HMS-RIC/Two-Armed-Bandit-PCB/Two Armed Bandit BOM.xlsx

Two Armed Bandit PCB
Bill of Materials
Value | Description | Qty | Vendor | Part Number | Price | Total | Notes
U1 | ULN2803A (Darlington Array) | 1 | Digikey | 497-2356-5-ND | $1.19 | $1.19 | Can be exchanged with ULQ2803A
J23 | BNCPTH | 1 | Digikey | A97555-ND | $2.15 | $2.15 | Substitute with any comparable part
J5–7, 10,15, 17 | 2-pin header (MTA-100) | 6 |  | A19423-ND | $0.10 | $0.60 | Or any other suitable connector
J3, J4, J12 | 3-pin header (MTA-100) | 3 |  | A19430-ND | $0.14 | $0.42 | Or any other suitable connector
J1, J2, J11 | 5x screw term, 3.5mm | 3 |  | 277-5827-ND | $3.26 | $3.26 | Alternatively: WM7861-ND
J8, J9, J16, J19 | 6x screw term, 3.5mm | 4 |  | 277-5779-ND | $3.74 | $14.96 | Alternatively: WM7862-ND
J13 | 8-pin socket | 1 |  | S7041-ND | $0.67 | $0.67
J14 | PJ-202A Power Jack | 1 |  | CP-202A-ND | $0.60 | $0.60
R1, R2, R5 | axial resistor for LED | 3 |  |  |  | $0.00
R3, R4, R6 | 160 Ω axial resistor | 3 |  |  |  | $0.00
J30 | 10-pin header | 1 |  | S1012EC-40-ND | $0.51 | $0.51 | get 40-pin header and break to size
J31,32 | 8-pin header | 0 |  | S1012EC-40-ND |  | $0.00 | get 40-pin header and break to size
J33 | 6-pin header | 0 |  | S1012EC-40-ND |  | $0.00 | get 40-pin header and break to size
 | For Ribbon Cable Connectors:
 | 2-pin MTA-100 connector (for ribbon) |  |  | A31080-ND | $0.15
 | 3-pin MTA-100 connector (for ribbon) |  |  | A31081-ND | $0.19
 | MTA-100 Crimper (if needed) |  |  | 58579-1 | $400.00 |  | Can be found at Digikey, Newark, Amazon, or direct from TE connectivity
 | Arduino Uno | 1 |  |  |  | $0.00
 | 1" Standoffs 4-40 | 4 | McMaster | 92745A326 | $0.46 | $1.84
