HMS-RIC/Two-Armed-Bandit-PCB/Gerber/v1.1/TwoArmedBandit_v1.1.dxf

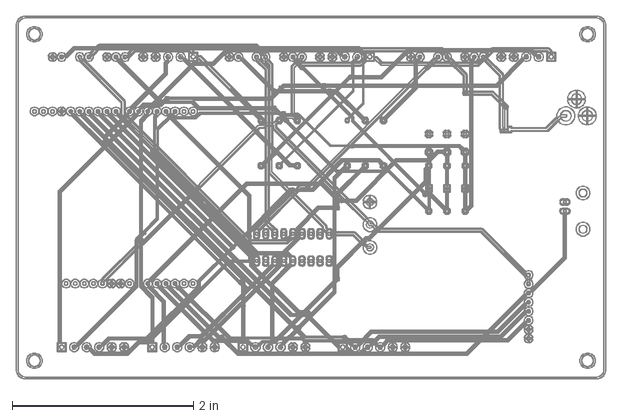
[picture p1: CAD file, 2020-10-27]
Gerber/v1.1/TwoArmedBandit_v1.1.dxf
6.50 x 4.00 in
