HMS-RIC/Two-Armed-Bandit-PCB/Gerber/v1.0/TwoArmedBandit_v1.dxf

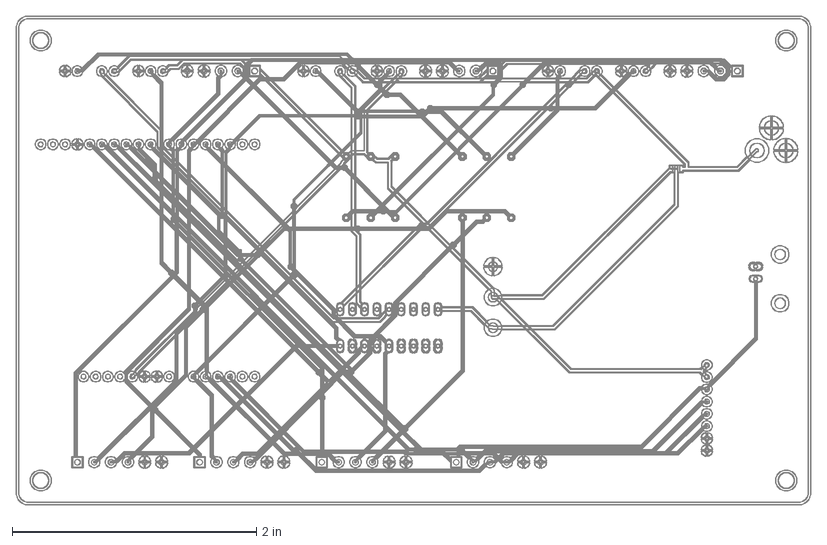
[picture p2: CAD file, 2020-07-29, an earlier design]
Gerber/v1.0/TwoArmedBandit_v1.dxf
6.50 x 4.00 in
