HMS-RIC/Two-Armed-Bandit-PCB/TwoArmedBandit_SCH_v1.1.pdf

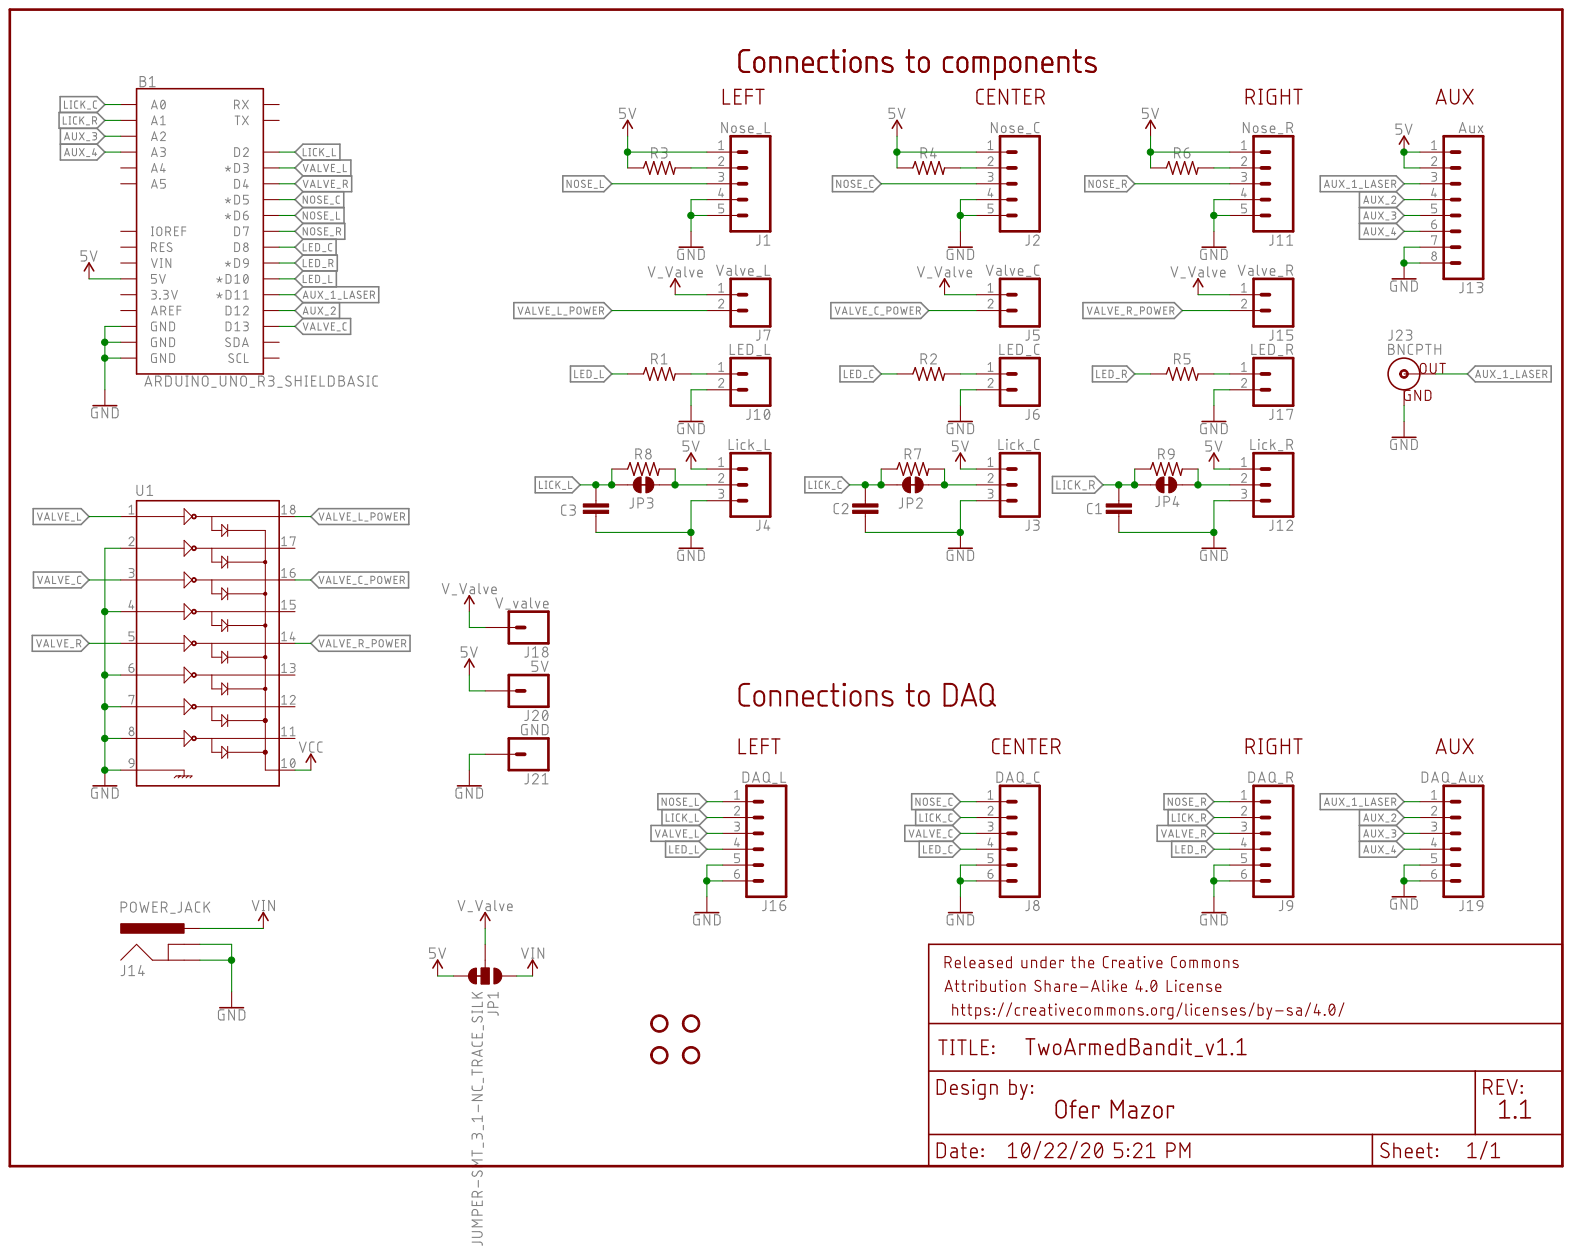
[picture p3: page 1]
