HMS-RIC/Two-Armed-Bandit-PCB/TwoArmedBandit_BRD_v1.1.pdf

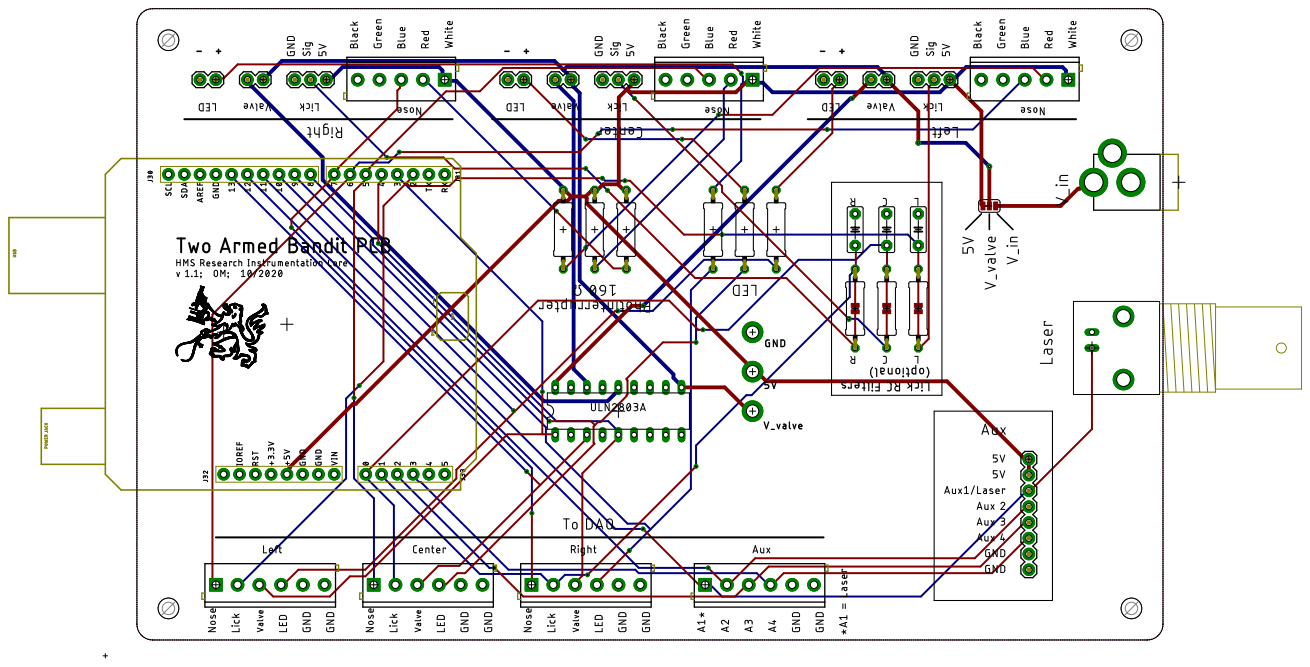
[picture p4: page 1]
