HMS-RIC/Two-Armed-Bandit-PCB/TwoArmedBandit_v1.1.brd

## EAGLE design TwoArmedBandit_v1.1.brd (2020-10-27)

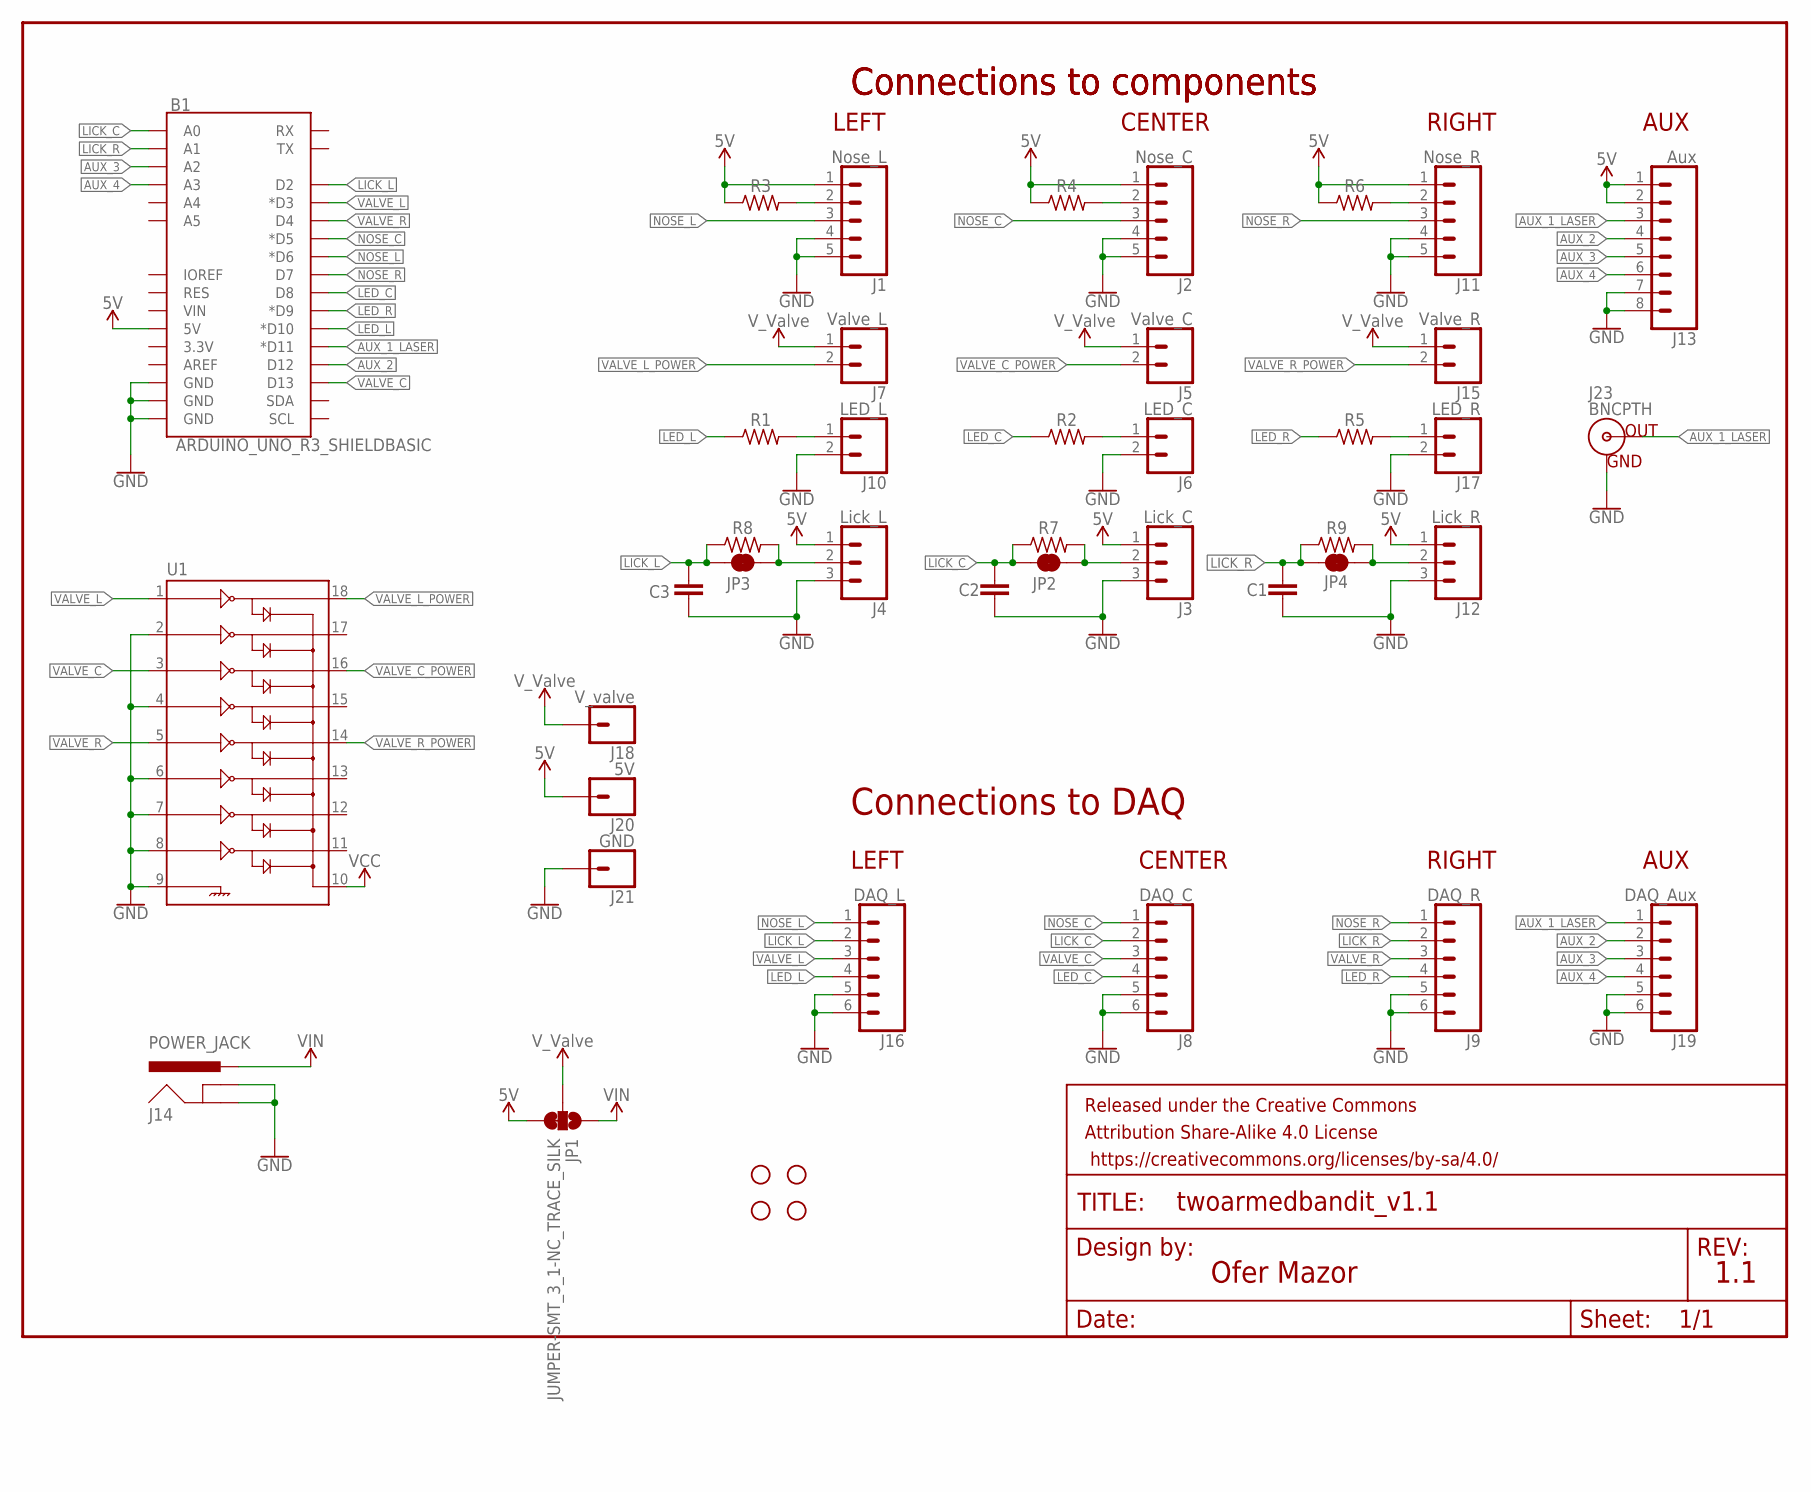
[picture p5: schematic TwoArmedBandit_v1.1.sch]

Parts:
B1: ARDUINO_UNO_R3_SHIELDBASIC; UNO_R3_SHIELD
C1, C2, C3: C5/2.5; C5B2.5
FRAME1: FRAME-LETTERNO_PACKAGE; DUMMY
H1, H2, H3, H4: STAND-OFF
J1: Nose_L; SCREWTERMINAL-3.5MM-5
J2: Nose_C; SCREWTERMINAL-3.5MM-5
J3: Lick_C; 1X03
J4: Lick_L; 1X03
J5: Valve_C; 1X02
J6: LED_C; 1X02
J7: Valve_L; 1X02
J8: DAQ_C; SCREWTERMINAL-3.5MM-6
J9: DAQ_R; SCREWTERMINAL-3.5MM-6
J10: LED_L; 1X02
J11: Nose_R; SCREWTERMINAL-3.5MM-5
J12: Lick_R; 1X03
J13: Aux; 1X08
J14: POWER_JACK; POWER_JACK_PTH
J15: Valve_R; 1X02
J16: DAQ_L; SCREWTERMINAL-3.5MM-6
J17: LED_R; 1X02
J18: V_valve; 1X01_2MM
J19: DAQ_Aux; SCREWTERMINAL-3.5MM-6
J20: 5V; 1X01_2MM
J21: GND; 1X01_2MM
J23: BNCPTH; BNC
JP1: JUMPER-SMT_3_1-NC_TRACE_SILK; SMT-JUMPER_3_1-NC_TRACE_SILK
JP2, JP3, JP4: JUMPER-SMT_2_NC_TRACE_NO-SILK; SMT-JUMPER_2_NC_TRACE_NO-SILK
R1, R2, R5: 330; 0309/12
R3, R4, R6, R7, R8, R9: 160; 0309/12
U1: ULN2803DIP; DIL18

Connections:
5V: B1.5V, J1.1, J2.1, J3.1, J4.1, J11.1, J12.1, J13.1, J13.2, J20.1, JP1.3, R3.1, R4.1, R6.1
AUX_1_LASER: B1.D11 (*D11), J13.3, J19.1, J23.S (OUT)
AUX_2: B1.D12, J13.4, J19.2
AUX_3: B1.A2, J13.5, J19.3
AUX_4: B1.A3, J13.6, J19.4
GND: B1.GND@0 (GND), B1.GND@1 (GND), B1.GND@2 (GND), C1.2, C2.2, C3.2, J1.4, J1.5, J2.4, J2.5, J3.3, J4.3, J6.2, J8.5, J8.6, J9.5, J9.6, J10.2, J11.4, J11.5, J12.3, J13.7, J13.8, J14.GND, J14.GNDBREAK, J16.5, J16.6, J17.2, J19.5, J19.6, J21.1, J23.GND, U1.2, U1.4, U1.6, U1.7, U1.8, U1.9
LED_C: B1.D8, J8.4, R2.1
LED_L: B1.D10 (*D10), J16.4, R1.1
LED_R: B1.D9 (*D9), J9.4, R5.1
LICK_C: B1.A0, C2.1, J8.2, JP2.1, R7.1
LICK_L: B1.D2, C3.1, J16.2, JP3.1, R8.1
LICK_R: B1.A1, C1.1, J9.2, JP4.1, R9.1
unnamed: J2.2, R4.2
unnamed: J1.2, R3.2
unnamed: J6.1, R2.2
unnamed: J11.2, R6.2
unnamed: J17.1, R5.2
unnamed: J12.2, JP4.2, R9.2
unnamed: J3.2, JP2.2, R7.2
unnamed: J4.2, JP3.2, R8.2
unnamed: J10.1, R1.2
NOSE_C: B1.D5 (*D5), J2.3, J8.1
NOSE_L: B1.D6 (*D6), J1.3, J16.1
NOSE_R: B1.D7, J9.1, J11.3
VALVE_C: B1.D13, J8.3, U1.3
VALVE_C_POWER: J5.2, U1.16
VALVE_L: B1.D3 (*D3), J16.3, U1.1
VALVE_L_POWER: J7.2, U1.18
VALVE_R: B1.D4, J9.3, U1.5
VALVE_R_POWER: J15.2, U1.14
VIN: J14.PWR, JP1.1
V_VALVE: J5.1, J7.1, J15.1, J18.1, JP1.2, U1.10

Notes on the sheet:
Connections to components
Connections to DAQ
LEFT
CENTER
RIGHT
AUX
Ofer Mazor
1.1

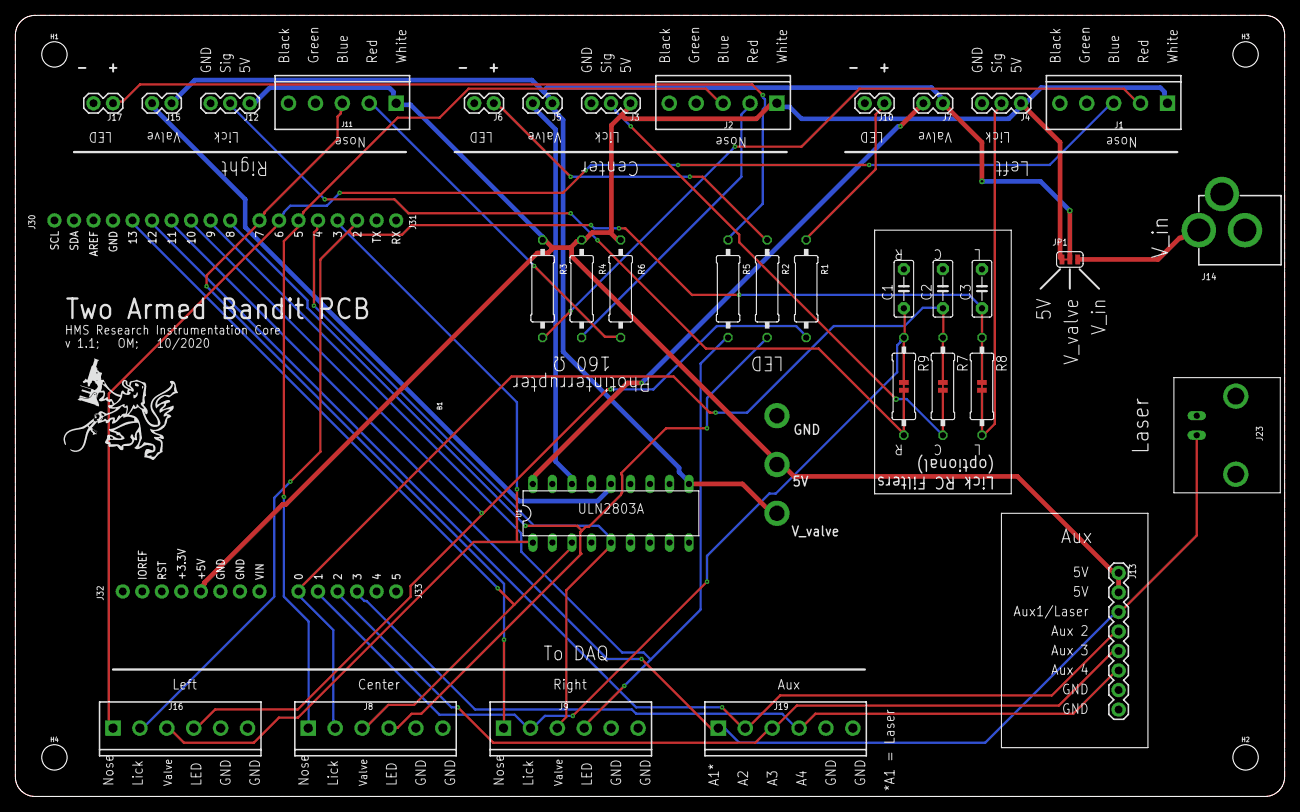
[picture p6: board TwoArmedBandit_v1.1.brd from above]

Board: 2 copper layers, 165.1 x 101.6 mm, 46 parts (0 on the bottom side), 32 nets.

Other parts of the board:
U$1: RIC_LOGO_BIG
