HMS-RIC/Two-Armed-Bandit-PCB/(commit log)

2020-07-29 Remove old files
    [TwoArmedBandit_old.brd, TwoArmedBandit_old.sch]
2020-07-29 Fix wiring of V_valve; Update version to v1.1
    [TwoArmedBandit_v1.1.brd, TwoArmedBandit_v1.1.sch]
2020-07-29 Add standoffs to BOM
    [Two Armed Bandit BOM.xlsx]
2020-07-29 Add PDF of schematic
2020-10-22 Swap pins for Aux-1/Aux-2
    In order for Aux-1-Laser to have PWM, needed to change
    Aux-1 to D11 and Aux-2 to D12.
    [TwoArmedBandit_v1.1.brd, TwoArmedBandit_v1.1.sch]
2020-10-22 Add optional RC filter to lick sensor output
    [TwoArmedBandit_v1.1.brd, TwoArmedBandit_v1.1.sch]
2020-10-22 Minor board fixes
    [TwoArmedBandit_v1.1.brd]
2020-10-27 Generate Gerbers and PDFs for v1.1
    [TwoArmedBandit_v1.1.brd, TwoArmedBandit_v1.1.dxf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]
2020-12-07 Remove old file
    [TwoArmedBandit_v1.csv]
2020-12-07 Update BOM for MTA-100 connectors
    [Two Armed Bandit BOM.xlsx]
2023-10-31 Add outline file to Gerbers
    [TwoArmedBandit_v1.1.GKO]
